resende-g/dark-BMO/docs/hardware.md

# Hardware

O conteúdo deste arquivo foi incorporado ao [README](../README.md), que é a fonte única da documentação do projeto. Seções correspondentes:

- [Lista de componentes (BOM)](../README.md#lista-de-componentes-bom)
- [Arquitetura](../README.md#arquitetura)
- [Pinagem (ESP32-S3 N16R8)](../README.md#pinagem-esp32-s3-n16r8)
- [Alimentação](../README.md#alimentação)
- [Configurações críticas](../README.md#configurações-críticas)
