resende-g/dark-BMO/docs/carcaca.md

# Carcaça 3D

O conteúdo deste arquivo foi incorporado ao [README](../README.md), que é a fonte única da documentação do projeto. Seções correspondentes:

- [Carcaça 3D](../README.md#carcaça-3d)
- [Fabricação: EasyEDA + JLCPCB](../README.md#fabricação-easyeda--jlcpcb-decidido)
- [Cartuchos de expansão](../README.md#cartuchos-de-expansão-o-que-o-card-edge-permite)
- [Anatomia de um cartucho](../README.md#anatomia-de-um-cartucho-importante)
- [Dimensões conhecidas](../README.md#dimensões-conhecidas)
