resende-g/dark-BMO/docs/roadmap.md

# Roadmap

O conteúdo deste arquivo foi incorporado ao [README](../README.md), que é a fonte única da documentação do projeto. Seções correspondentes:

- [Roadmap](../README.md#roadmap)
- [Montagem passo a passo](../README.md#montagem-passo-a-passo)
- [Decisões de projeto](../README.md#decisões-de-projeto)
