resende-g/dark-BMO/(commit log)

2026-10-22 docs: adiciona BOM, pinagem e alimentação
2026-10-22 docs: adiciona opções de firmware e plano
2026-10-22 chore: adiciona .gitignore para Arduino, PlatformIO e Python
2026-10-23 docs: remove o OLED dos docs (tela única ILI9341) e atualiza o rodapé do README
    - docs/hardware, firmware, roadmap e carcaca: sai o OLED SH1106 (BOM,
    arquitetura, I²C 0x3C, driver, recorte e dimensões); rosto do BMO passa
    a ser na tela principal ILI9341, desenhado com TFT_eSPI
    - docs/roadmap: registra a decisão "Segunda tela (OLED)" como no README
    - README e firmware: "speaker/mic/telas" vira "tela"
    - Rodapé do README sem "ferro-velho" e "teclado velho"
    Claude-Session: https://claude.ai/code/session_01LfpX2Fg9jZc9bQeYj98mCZ
2026-10-23 docs: README vira fonte única; docs/*.md passam a apontar para as seções dele
    O conteúdo de hardware, firmware, roadmap e carcaça já estava todo no
    README (checado termo a termo antes da troca). Cada arquivo agora é só um
    índice de links para as seções correspondentes, para não haver duas
    versões divergentes.
    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
2026-10-23 docs: README com a decisão de fabricação (EasyEDA + JLCPCB) e a traseira em duas zonas
    Conteúdo novo do README (reunião de 23/10/2026 com o Tiago Batista):
    - PCB projetada no EasyEDA e fabricada na JLCPCB, com carga/BMS/boost em
    SMD; saem perfboard, PCB caseira no laser e os módulos TP4056/MT3608
    - Card edge completo escolhido; conector fêmea definido primeiro
    - Traseira multifuncional (zona fixa + porta com bateria, cartuchos
    reserva e microSD), fecho por parafuso + lábio, rosca com standoff hex
    - Montagem, roadmap e decisões atualizados
    Mantidas as correções já feitas: capa, imagens dos cartuchos
    renderizadas, sem OLED (0x3C, SH1106, "telas"), Tiago Batista com
    sobrenome e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
2026-10-23 docs: registra decisões de hardware da reunião (soquete DK920A-20M, cartucho, carga USB-C, validação)
    Com base na reunião com o Tiago Batista (23/10/2026) e na pesquisa de fontes:
    - BOM: soquete card edge DK920A-20M (2x10, 2,54 mm)
    - Alimentação: limitar corrente de carga (~0,5C), BMS 1S obrigatório,
    e porta USB-C dedicada só para carga (2x 5,1k nos CC, cor na carcaça)
    - Card edge: soquete definido; contatos nos dois lados (2x10)
    - Nova seção "Especificação do cartucho": placa 52x52 mm, língua ~27,8 mm,
    contatos a 0,6 mm da borda, ENIG + chanfro 30°, anti-inversão, apoio
    mecânico, EEPROM de identificação; ponto em aberto da fenda frontal
    - Montagem: simulação do E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
2026-10-23 docs: adiciona cartuchos WAVE RIDER (LoRa 915 MHz) e EAGLE EYE (câmera) e os prompts
    - Imagens conceito dos dois novos cartuchos, no mesmo padrão da família
    (carcaça teal, contatos dourados, etiqueta estilo capa de jogo retrô)
    - docs/cartuchos-prompts.md: prompts de geração de imagem, com nome que
    codifica a função como título de jogo (sem logo de marca)
    - README: galeria com os quatro cartuchos; nota de que a câmera do EAGLE
    EYE fica na face frontal (módulo virado para fora, furo na carcaça)
    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
2026-10-23 docs: capa nova do BMO (com slot de cartucho) e remove os 2 conceitos genéricos
    - docs/img/bmo-capa.jpg: BMO v1 com o slot de cartucho card edge acima do
    D-pad (contatos dourados visíveis); vira a capa e o conceito visual v1
    - Remove cartucho-conceito.jpg e cartucho-lora-conceito.jpg, já substituídos
    por WAVE RIDER e EAGLE EYE
    - README: galeria passa a mostrar capa + os 2 cartuchos reais; capa maior (640px)
    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
2026-10-23 docs: adiciona imagem 1280x640 para o social preview do GitHub
    Versão da capa recortada para 2:1 (1280x640, tamanho do Social preview),
    com o BMO inteiro e sem corte. Upload é manual em Settings > General.
    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
2026-10-23 docs: renomeia a capa para bmo-capa-v1.jpg (força o GitHub a atualizar a imagem)
    O conteúdo da capa já era o BMO novo (com slot), mas o GitHub cacheia a
    imagem pela URL e seguia mostrando a antiga. Novo nome = nova URL = cache
    invalidado.
    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
2026-10-24 feat: adiciona sketches de teste de bancada da tela e do CC1101
    teste_tela lê o ID do ILI9341 e passa cores e rotações; teste_cc1101 lê
    PARTNUM/VERSION por SPI e confere o fio do GDO0. Ambos usam a pinagem do
    README e deixam os outros CS do barramento em HIGH.
2026-10-24 docs: registra núcleo recebido, tela touch MSP3218 e medidas da tela
    A tela chegou na versão touch (14 pinos, XPT2046), com o toque e o slot SD
    do verso sem uso no v1; o microSD segue no módulo separado da porta
    traseira. Medidas da placa atualizadas (datasheet + régua) e os sketches de
    bancada apontados na montagem.
2026-10-24 feat: adiciona build próprio do Bruce para o BMO (tela ILI9341, 3 botões e CC1101)
    O binário oficial do Bruce para a DevKitC-1 não usa tela nem botões e põe o
    CC1101 no CS 10, que é o da tela. A placa bmo-v1 parte da ESP-General do
    Bruce 1.16.1 e define tudo por flags, sem alterar o código dele: tela
    ILI9341 no SPI compartilhado (USE_HSPI_PORT, senão trava no boot do S3),
    botões em 39/2/47 e CC1101 em CS 14 e GDO0 15. FastLED fica de fora (sem LED
    RGB; a versão nova quebra com o -DFP do Bruce).
    build.sh baixa o Bruce na versão fixada, copia a placa e compila ou grava
    com o PlatformIO de um venv em Python 3.14.
    [interface.cpp]
2026-10-24 docs: registra a bancada com o Bruce, a pinagem dos botões e o build
    README: status da bancada, botões cima/OK/baixo em 39/2/47, pinos do Bruce
    fixados na compilação, como compilar e gravar o Bruce e o roadmap com a
    tela validada. Sketches de teste: o serial sai pela porta USB nativa, com
    USB CDC On Boot ativado.
    [teste_cc1101.ino, teste_tela.ino]
2026-11-02 docs: add preliminary DBBS 1.0 battery architecture
2026-11-02 docs: record AliExpress battery and BMS candidates
2026-11-02 docs: migrate BOM and architecture to ESP32-P4+C6
2026-11-02 docs: update BOM for owned parts, momentary power button and connectors
2026-11-02 docs: adopt original d-BMO identity for the hardware
    - Replace the Adventure Time-inspired look (teal body, legs, colored
    buttons, front cartridge slot) with the d-BMO spec from resende-g/BMO
    - Move the card edge slot to the top edge via a riser board
    - Settle input: D-pad + buttons + two PS3 analog sticks on the ADC
    - Note that a metal body would block NFC and attenuate RF
    - Swap the cover image for the d-BMO concept reference; drop old images
    - Update cartridge prompts to the graphite/silver palette
2026-11-02 docs: record board, phased purchases and battery safety review
    - Identify the board as Guition JC-ESP32P4-M3-DEV (IPEX antenna, SD slot)
    - Drop the SPI microSD module and AliExpress wire from the cart
    - Add the 2.4 GHz IPEX antenna; the CC1101 antenna does not fit the C6
    - Split purchases into five phases; carcass v0 only after phase 2
    - Add battery risks and open power decisions; fix the 1 A charge note
2026-11-02 docs: reuse PS3 controller sticks, tactile shoulder buttons, antenna and NTC notes
2026-11-02 docs: reuse PS3 controller button caps, D-pad and trigger plastics
2026-11-03 docs: keep ESP32-S3 N16R8 as the v1 platform and defer the P4
    - Restore and extend the S3 pinout (ADC1 sticks, MCP23017 buttons, cartridge)
    - Drop the P4 board and IPEX antenna from the BOM; phase 1 is jumpers only
    - Use the display module SD slot; recommend a 3.3 V buck-boost instead of 5 V
    - Record why the P4 move was deferred to a v2
2026-11-03 docs: display module has a full-size SD slot; use a microSD adapter
2026-11-03 feat(rosto): add d-BMO face sketch with the 10 spec states
    - 16x12 block grid drawn by code, only changed blocks redrawn
    - OK button (GPIO 2) or serial (number or name) switches state
    - Host-side check of the face table in firmware/rosto/teste
    - Display test now points the SD slot to CS 21 with a microSD adapter
2026-11-03 docs: volume by select + D-pad shortcut, no volume buttons
2026-11-03 docs: new cartridge art, renamed BRAVE NEW WORLD (LoRa) and BIG BROTHER (camera)
2026-11-03 docs: use the d-BMO-body render as README cover
    Symbols removed from the action buttons and only the front view kept
    (drops the NFC N-Mark on the back).
